IsSasoriDev/HX6-Miner/fab/HX6_revB_BOM_JLCPCB.csv

Comment | Designator | Footprint | Quantity | Manufacturer Part | LCSC Part #
XT60 12V in | J1 | AMASS_XT60-M_1x02_P7.20mm_Vertical | 1 | AMASS XT60PW-M (vertical)
15A mini blade | F1 | Fuseholder_Blade_Mini_Keystone_3568 | 1 | Keystone 3568 holder + 15 A mini blade fuse
SMBJ15CA | D1 | D_SMB | 1 | SMBJ15CA (bidirectional)
270u 16V | C1,C2,C3,C4 | CP_Elec_8x10 | 4 | Panasonic 16SVPF270M (polymer)
100k | R1,R3,R5,R7,R14,R23 | R_0402_1005Metric | 6
10k | R2,R11,R13,R16,R19,R21,R22,R24,R34,R35,R36,R38,R39,R41,R42,R44,R45,R47,R48,R50,R51,R52,R53,R56,R57,R61,R62 | R_0402_1005Metric | 27
100n | C5,C8,C9,C13,C14,C80,C81,C92,C93,C104,C105,C116,C117,C128,C129,C140,C141,C144,C145,C146,C147,C148,C149,C151,C154 | C_0402_1005Metric | 25
TPS54302 | U1,U2 | SOT-23-6 | 2 | TPS54302DDCR
33k | R4 | R_0402_1005Metric | 1
10u 25V | C6,C7,C12 | C_1206_3216Metric | 3
10u | L1 | L_Bourns_SRP7028A_7.3x6.6mm | 1 | Bourns SRP7028A-100M
13.3k | R6 | R_0402_1005Metric | 1
22u 10V | C10,C11,C15,C16,C150 | C_0805_2012Metric | 5
SS34 | D2 | D_SMA | 1 | SS34
6.8u | L2 | L_Bourns_SRP7028A_7.3x6.6mm | 1 | Bourns SRP7028A-6R8M
22.1k | R8 | R_0402_1005Metric | 1
Green | D3 | LED_0603_1608Metric | 1
1k | R9,R33,R37,R40,R43,R46,R49,R58 | R_0402_1005Metric | 8
TLV75801 | U3,U4 | SOT-23-5 | 2 | TLV75801PDBVR
12k | R10 | R_0402_1005Metric | 1
1u | C17,C19,C22,C24,C29,C40,C51,C62,C152 | C_0603_1608Metric | 9
10u | C18,C20,C153 | C_0805_2012Metric | 3
4.53k | R12 | R_0402_1005Metric | 1
TPS53647 | U5 | Texas_RHA0040B_VQFN-40-1EP_6x6mm_P0.5mm_EP4.15x4.15mm_ThermalVias | 1 | TPS53647RTAR
10 | R15 | R_0603_1608Metric | 1
1u 25V | C21 | C_0603_1608Metric | 1
2.2u | C23 | C_0603_1608Metric | 1
14.7k | R17 | R_0402_1005Metric | 1
150k | R18 | R_0402_1005Metric | 1
2.2n | C25 | C_0402_1005Metric | 1
47p | C26 | C_0402_1005Metric | 1
0 | R25,R27,R28 | R_0402_1005Metric | 3
75k | R26 | R_0402_1005Metric | 1
1n | C27 | C_0402_1005Metric | 1
CSD95490Q5MC | U6,U7,U8,U9 | TI_DMC0012A_VSON-CLIP_5x6mm | 4 | CSD95490Q5MC
110k | R29,R30,R31,R32 | R_0402_1005Metric | 4
100n 16V | C28,C39,C50,C61 | C_0402_1005Metric | 4
22u 25V | C30,C31,C41,C42,C52,C53,C63,C64 | C_1210_3225Metric | 8
100n 25V | C32,C43,C54,C65 | C_0402_1005Metric | 4
150n | L3,L4,L5,L6 | L_Coilcraft_XAL7070-XXX | 4 | Coilcraft XAL7070-151MEC
47u 6.3V | C33,C34,C35,C36,C44,C45,C46,C47,C55,C56,C57,C58,C66,C67,C68,C69 | C_1206_3216Metric | 16
470u 2.5V | C37,C38,C48,C49,C59,C60,C70,C71 | CP_EIA-7343-31_Kemet-D | 8 | Panasonic 2R5TPF470M6L (POSCAP)
BM1370 | U10,U11,U12,U13,U14,U15 | BM1370 | 6 | Bitmain BM1370
1u 25V | C72,C73,C74,C75,C76,C77,C78,C79,C84,C85,C86,C87,C88,C89,C90,C91,C96,C97,C98,C99,C100,C101,C102,C103,C108,C109,C110,C111,C112,C113,C114,C115,C120,C121,C122,C123,C124,C125,C126,C127,C132,C133,C134,C135,C136,C137,C138,C139 | C_0402_1005Metric | 48
22u 6.3V | C82,C83,C94,C95,C106,C107,C118,C119,C130,C131,C142,C143 | C_0805_2012Metric | 12
TXU0304 | U16 | TSSOP-14_4.4x5mm_P0.65mm | 1 | TXU0304PWR
25MHz 1.2V | Y1 | Oscillator_SMD_Abracon_ASE-4Pin_3.2x2.5mm | 1 | Taitien OXLTDLJANF-25.000000 (1.2 V CMOS)
TMP1075 | U17,U18,U19 | SO-8_3.9x4.9mm_P1.27mm | 3 | TMP1075DR
ESP32-S3-WROOM-1-N16R8 | U20 | ESP32-S3-WROOM-1 | 1 | ESP32-S3-WROOM-1-N16R8
4.7k | R54,R55 | R_0402_1005Metric | 2
BOOT | SW1 | SW_SPST_TL3342 | 1 | TE FSMSM / TL3342
RESET | SW2 | SW_SPST_TL3342 | 1 | TE FSMSM / TL3342
USER | SW3 | SW_SPST_TL3342 | 1 | TE FSMSM / TL3342
Blue | D4 | LED_0603_1608Metric | 1
UART0 | J2 | PinHeader_1x03_P2.54mm_Vertical | 1
USB-C | J3 | USB_C_Receptacle_HRO_TYPE-C-31-M-12 | 1 | HRO TYPE-C-31-M-12
5.1k | R59,R60 | R_0402_1005Metric | 2
USBLC6-2SC6 | U21 | SOT-23-6 | 1 | USBLC6-2SC6
Waveshare 2.8in CTP | J4 | JST_GH_SM13B-GHS-TB_1x13-1MP_P1.25mm_Horizontal | 1 | JST SM13B-GHS-TB (GH 1.25 mm, 13 pin)
EMC2302-1 | U22 | MSOP-10_3x3mm_P0.5mm | 1 | EMC2302-1-AIZL
FAN1 | J5 | FanPinHeader_1x04_P2.54mm_Vertical | 1 | Molex 47053-1000
FAN2 | J6 | FanPinHeader_1x04_P2.54mm_Vertical | 1 | Molex 47053-1000
