IsSasoriDev/HX6-Miner/hx6.kicad_pcb

## KiCad design hx6.kicad_pcb (2026-10-30)

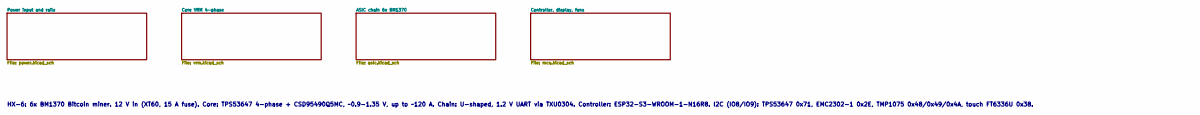
[picture p5: schematic hx6.kicad_sch, HX-6 6x BM1370 miner]

Notes on the sheet:
HX-6: 6x BM1370 Bitcoin miner. 12 V in (XT60, 15 A fuse). Core: TPS53647 4-phase + CSD95490Q5MC, ~0.9-1.35 V, up to ~120 A. Chain: U-shaped, 1.2 V UART via TXU0304. Controller: ESP32-S3-WROOM-1-N16R8. I2C (IO8/IO9): TPS53647 0x71, EMC2302-1 0x2E, TMP1075 0x48/0x49/0x4A, touch FT6336U 0x38.

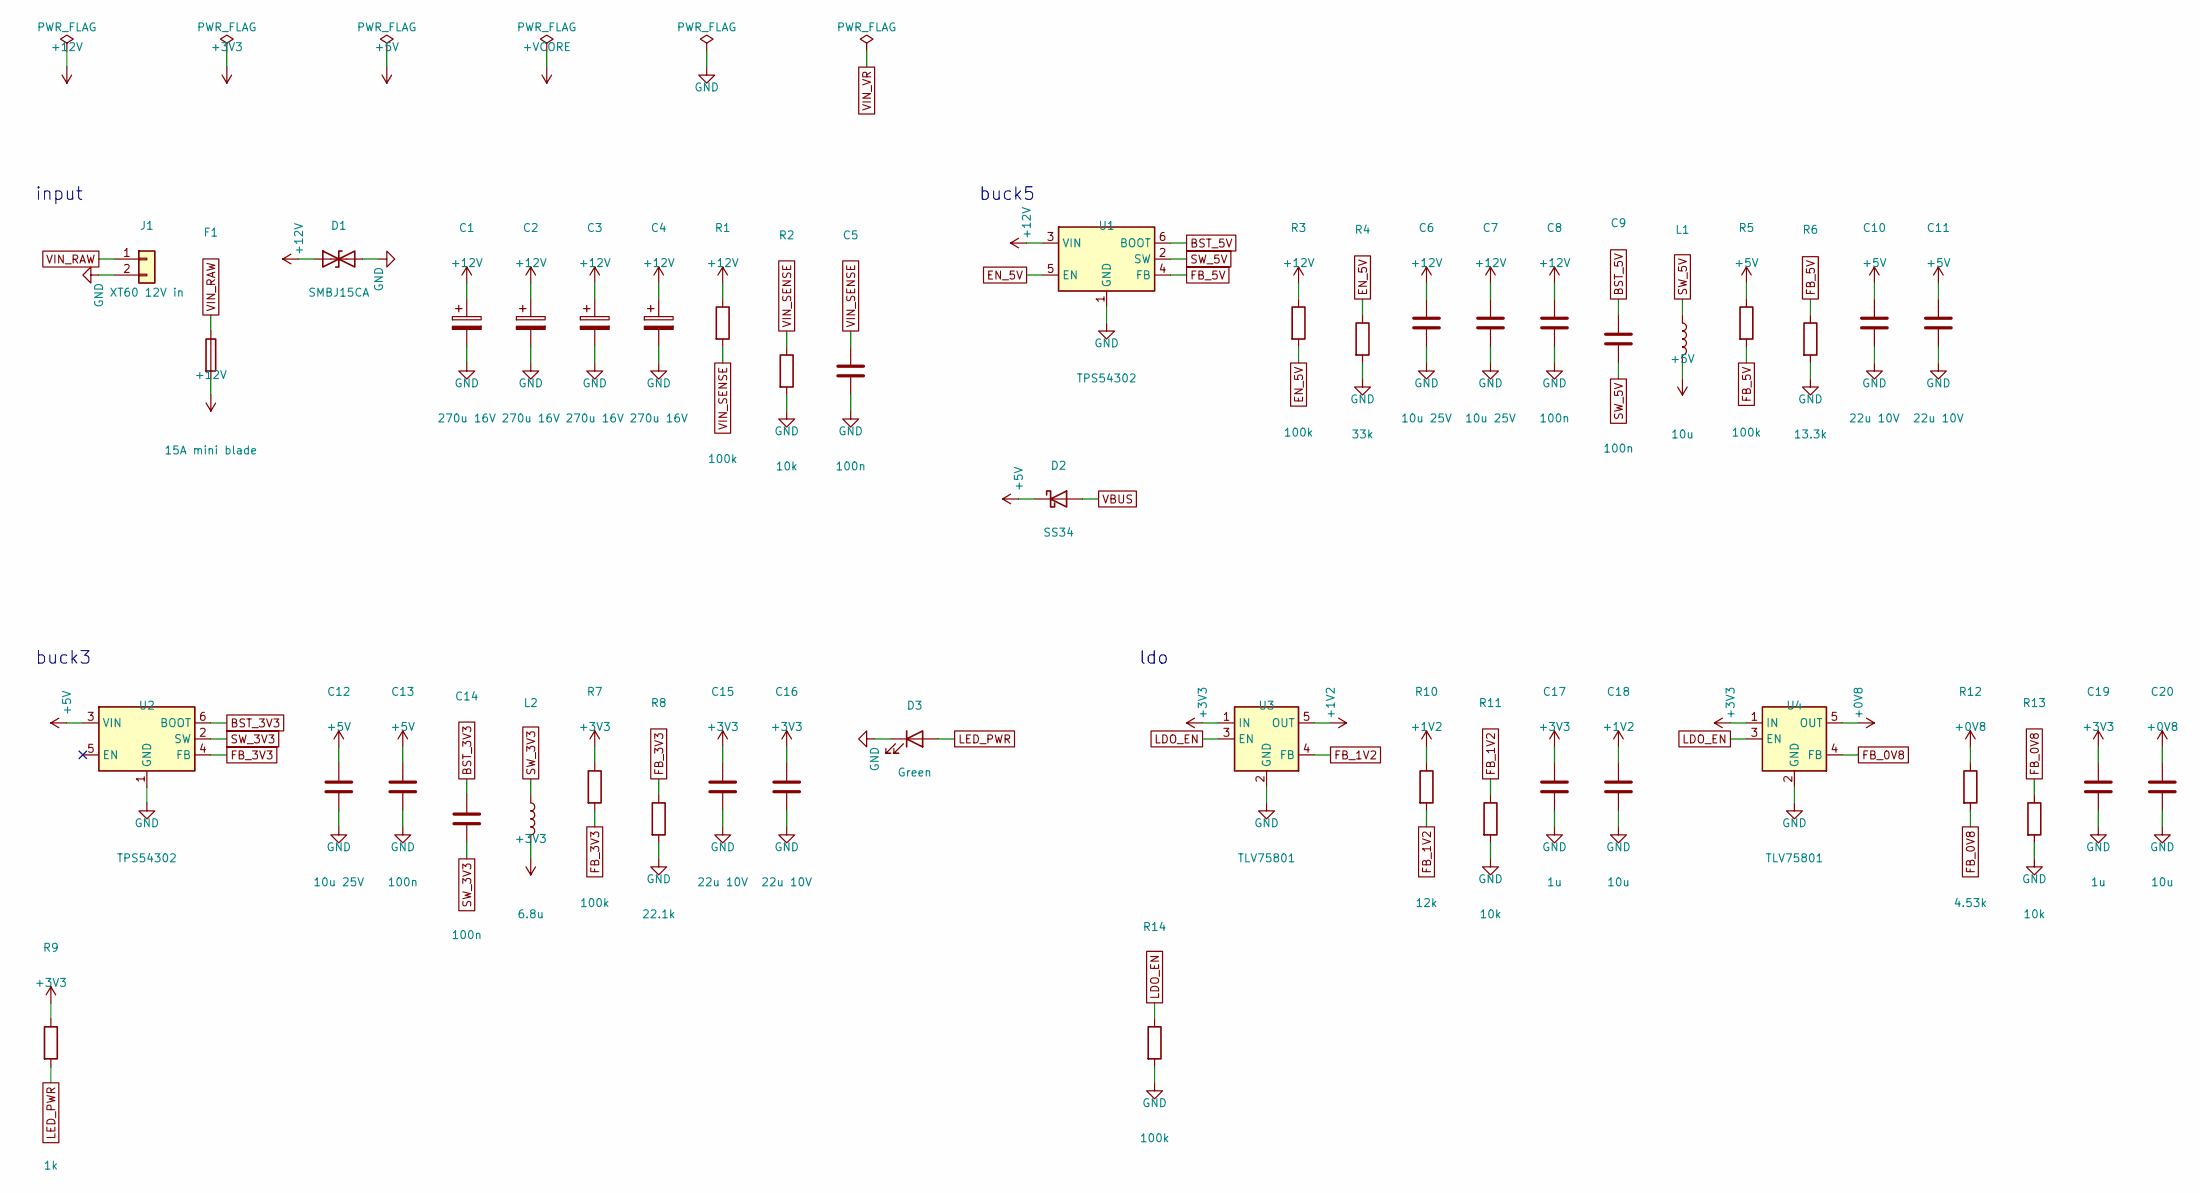
[picture p6: schematic power.kicad_sch, HX-6 Power input and rails]

Parts:
C1, C2, C3, C4: 270u 16V; CP_Elec_8x10; MPN Panasonic 16SVPF270M (polymer)
C5, C8, C9, C13, C14: 100n; C_0402_1005Metric
C6, C7, C12: 10u 25V; C_1206_3216Metric
C10, C11, C15, C16: 22u 10V; C_0805_2012Metric
C17, C19: 1u; C_0603_1608Metric
C18, C20: 10u; C_0805_2012Metric
D1: SMBJ15CA; D_SMB; MPN SMBJ15CA (bidirectional)
D2: SS34; D_SMA; MPN SS34
D3: Green; LED_0603_1608Metric
F1: 15A mini blade; Fuseholder_Blade_Mini_Keystone_3568; MPN Keystone 3568 holder + 15 A mini blade 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
J1: XT60 12V in; AMASS_XT60-M_1x02_P7.20mm_Vertical; MPN AMASS XT60PW-M (vertical)
L1: 10u; L_Bourns_SRP7028A_7.3x6.6mm; MPN Bourns SRP7028A-100M
L2: 6.8u; L_Bourns_SRP7028A_7.3x6.6mm; MPN Bourns SRP7028A-6R8M
R1, R3, R5, R7, R14: 100k; R_0402_1005Metric
R2, R11, R13: 10k; R_0402_1005Metric
R4: 33k; R_0402_1005Metric
R6: 13.3k; R_0402_1005Metric
R8: 22.1k; R_0402_1005Metric
R9: 1k; R_0402_1005Metric
R10: 12k; R_0402_1005Metric
R12: 4.53k; R_0402_1005Metric
U1, U2: TPS54302; SOT-23-6; MPN TPS54302DDCR
U3, U4: TLV75801; SOT-23-5; MPN TLV75801PDBVR

Connections:
+0V8: C20.1, R12.1, U4.5 (OUT); also elsewhere on the board
+1V2: C18.1, R10.1, U3.5 (OUT); also elsewhere on the board
+3V3: C15.1, C16.1, C17.1, C19.1, L2.2, R7.1, R9.1, U3.1 (IN), U4.1 (IN); also elsewhere on the board
+5V: C10.1, C11.1, C12.1, C13.1, D2.1 (K), L1.2, R5.1, U2.3 (VIN); also elsewhere on the board
+12V: C1.1, C2.1, C3.1, C4.1, C6.1, C7.1, C8.1, D1.1 (A1), F1.2, R1.1, R3.1, U1.3 (VIN); also elsewhere on the board
BST_3V3: C14.1, U2.6 (BOOT)
BST_5V: C9.1, U1.6 (BOOT)
EN_5V: R3.2, R4.1, U1.5 (EN)
FB_0V8: R12.2, R13.1, U4.4 (FB)
FB_1V2: R10.2, R11.1, U3.4 (FB)
FB_3V3: R7.2, R8.1, U2.4 (FB)
FB_5V: R5.2, R6.1, U1.4 (FB)
GND: C1.2, C2.2, C3.2, C4.2, C5.2, C6.2, C7.2, C8.2, C10.2, C11.2, C12.2, C13.2, C15.2, C16.2, C17.2, C18.2, C19.2, C20.2, D1.2 (A2), D3.1 (K), J1.2, R2.2, R4.2, R6.2, R8.2, R11.2, R13.2, R14.2, U1.1 (GND), U2.1 (GND), U3.2 (GND), U4.2 (GND); also elsewhere on the board
LDO_EN: R14.1, U3.3 (EN), U4.3 (EN); also elsewhere on the board
LED_PWR: D3.2 (A), R9.2
SW_3V3: C14.2, L2.1, U2.2 (SW)
SW_5V: C9.2, L1.1, U1.2 (SW)
VBUS: D2.2 (A); also elsewhere on the board
VIN_RAW: F1.1, J1.1
VIN_SENSE: C5.1, R1.2, R2.1; also elsewhere on the board

Notes on the sheet:
input
buck5
buck3
ldo

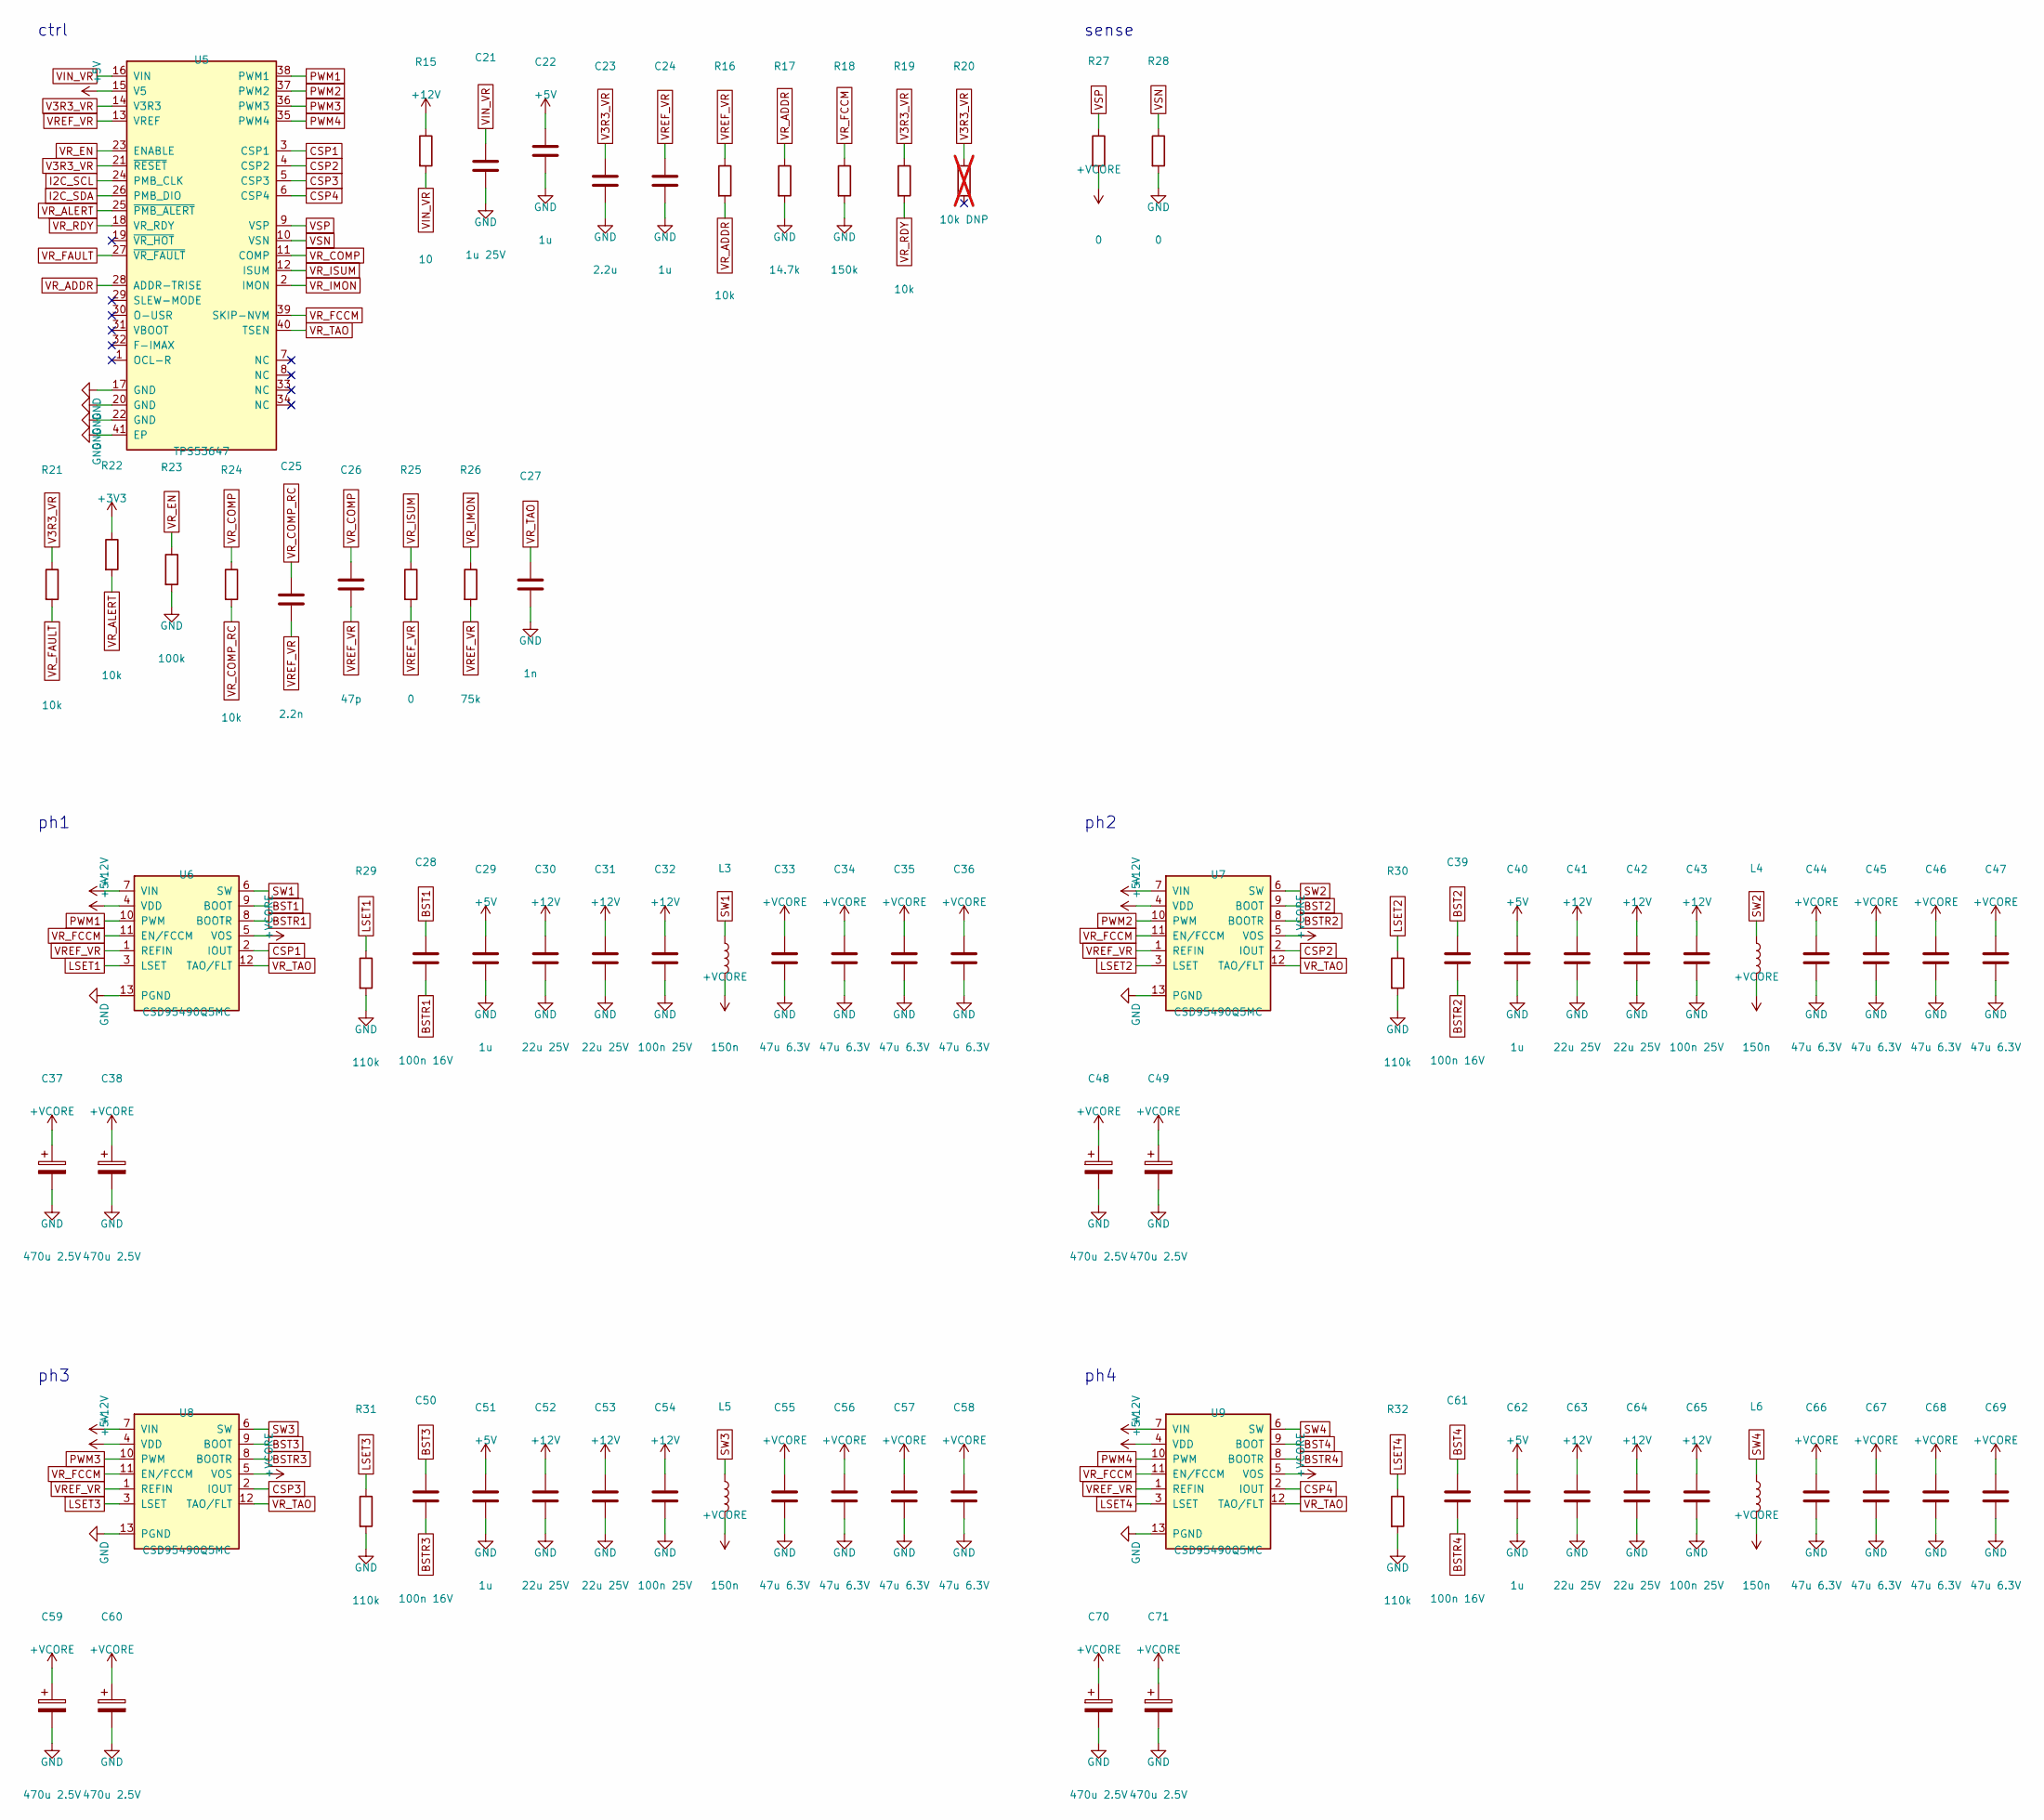
[picture p7: schematic vrm.kicad_sch, HX-6 Core VRM 4-phase]

Parts:
C21: 1u 25V; C_0603_1608Metric
C22, C24, C29, C40, C51, C62: 1u; C_0603_1608Metric
C23: 2.2u; C_0603_1608Metric
C25: 2.2n; C_0402_1005Metric
C26: 47p; C_0402_1005Metric
C27: 1n; C_0402_1005Metric
C28, C39, C50, C61: 100n 16V; C_0402_1005Metric
C30, C31, C41, C42, C52, C53, C63, C64: 22u 25V; C_1210_3225Metric
C32, C43, C54, C65: 100n 25V; C_0402_1005Metric
C33, C34, C35, C36, C44, C45, C46, C47, C55, C56, C57, C58, C66, C67, C68, C69: 47u 6.3V; C_1206_3216Metric
C37, C38, C48, C49, C59, C60, C70, C71: 470u 2.5V; CP_EIA-7343-31_Kemet-D; MPN Panasonic 2R5TPF470M6L (POSCAP)
L3, L4, L5, L6: 150n; L_Coilcraft_XAL7070-XXX; MPN Coilcraft XAL7070-151MEC
R15: 10; R_0603_1608Metric
R16, R19, R21, R22, R24: 10k; R_0402_1005Metric
R17: 14.7k; R_0402_1005Metric
R18: 150k; R_0402_1005Metric
R20: 10k DNP; R_0402_1005Metric; not fitted
R23: 100k; R_0402_1005Metric
R25, R27, R28: 0; R_0402_1005Metric
R26: 75k; R_0402_1005Metric
R29, R30, R31, R32: 110k; R_0402_1005Metric
U5: TPS53647; Texas_RHA0040B_VQFN-40-1EP_6x6mm_P0.5mm_EP4.15x4.15mm_Therm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; MPN TPS53647RTAR
U6, U7, U8, U9: CSD95490Q5MC; TI_DMC0012A_VSON-CLIP_5x6mm; MPN CSD95490Q5MC

Connections:
+3V3: R22.1; also elsewhere on the board
+5V: C22.1, C29.1, C40.1, C51.1, C62.1, U5.15 (V5), U6.4 (VDD), U7.4 (VDD), U8.4 (VDD), U9.4 (VDD); also elsewhere on the board
+12V: C30.1, C31.1, C32.1, C41.1, C42.1, C43.1, C52.1, C53.1, C54.1, C63.1, C64.1, C65.1, R15.1, U6.7 (VIN), U7.7 (VIN), U8.7 (VIN), U9.7 (VIN); also elsewhere on the board
+VCORE: C33.1, C34.1, C35.1, C36.1, C37.1, C38.1, C44.1, C45.1, C46.1, C47.1, C48.1, C49.1, C55.1, C56.1, C57.1, C58.1, C59.1, C60.1, C66.1, C67.1, C68.1, C69.1, C70.1, C71.1, L3.2, L4.2, L5.2, L6.2, R27.2, U6.5 (VOS), U7.5 (VOS), U8.5 (VOS), U9.5 (VOS); also elsewhere on the board
BST1: C28.1, U6.9 (BOOT)
BST2: C39.1, U7.9 (BOOT)
BST3: C50.1, U8.9 (BOOT)
BST4: C61.1, U9.9 (BOOT)
BSTR1: C28.2, U6.8 (BOOTR)
BSTR2: C39.2, U7.8 (BOOTR)
BSTR3: C50.2, U8.8 (BOOTR)
BSTR4: C61.2, U9.8 (BOOTR)
CSP1: U5.3 (CSP1), U6.2 (IOUT)
CSP2: U5.4 (CSP2), U7.2 (IOUT)
CSP3: U5.5 (CSP3), U8.2 (IOUT)
CSP4: U5.6 (CSP4), U9.2 (IOUT)
GND: C21.2, C22.2, C23.2, C24.2, C27.2, C29.2, C30.2, C31.2, C32.2, C33.2, C34.2, C35.2, C36.2, C37.2, C38.2, C40.2, C41.2, C42.2, C43.2, C44.2, C45.2, C46.2, C47.2, C48.2, C49.2, C51.2, C52.2, C53.2, C54.2, C55.2, C56.2, C57.2, C58.2, C59.2, C60.2, C62.2, C63.2, C64.2, C65.2, C66.2, C67.2, C68.2, C69.2, C70.2, C71.2, R17.2, R18.2, R23.2, R28.2, R29.2, R30.2, R31.2, R32.2, U5.17 (GND), U5.20 (GND), U5.22 (GND), U5.41 (EP), U6.13 (PGND), U7.13 (PGND), U8.13 (PGND), U9.13 (PGND); also elsewhere on the board
I2C_SCL: U5.24 (PMB_CLK); also elsewhere on the board
I2C_SDA: U5.26 (PMB_DIO); also elsewhere on the board
LSET1: R29.1, U6.3 (LSET)
LSET2: R30.1, U7.3 (LSET)
LSET3: R31.1, U8.3 (LSET)
LSET4: R32.1, U9.3 (LSET)
PWM1: U5.38 (PWM1), U6.10 (PWM)
PWM2: U5.37 (PWM2), U7.10 (PWM)
PWM3: U5.36 (PWM3), U8.10 (PWM)
PWM4: U5.35 (PWM4), U9.10 (PWM)
SW1: L3.1, U6.6 (SW)
SW2: L4.1, U7.6 (SW)
SW3: L5.1, U8.6 (SW)
SW4: L6.1, U9.6 (SW)
V3R3_VR: C23.1, R19.1, R20.1, R21.1, U5.14 (V3R3), U5.21 (~RESET)
VIN_VR: C21.1, R15.2, U5.16 (VIN)
VREF_VR: C24.1, C25.2, C26.2, R16.1, R25.2, R26.2, U5.13 (VREF), U6.1 (REFIN), U7.1 (REFIN), U8.1 (REFIN), U9.1 (REFIN)
VR_ADDR: R16.2, R17.1, U5.28 (ADDR-TRISE)
VR_ALERT: R22.2, U5.25 (~PMB_ALERT); also elsewhere on the board
VR_COMP: C26.1, R24.1, U5.11 (COMP)
VR_COMP_RC: C25.1, R24.2
VR_EN: R23.1, U5.23 (ENABLE); also elsewhere on the board
VR_FAULT: R21.2, U5.27 (~VR_FAULT)
VR_FCCM: R18.1, U5.39 (SKIP-NVM), U6.11 (EN/FCCM), U7.11 (EN/FCCM), U8.11 (EN/FCCM), U9.11 (EN/FCCM)
VR_IMON: R26.1, U5.2 (IMON)
VR_ISUM: R25.1, U5.12 (ISUM)
VR_RDY: R19.2, U5.18 (VR_RDY); also elsewhere on the board
VR_TAO: C27.1, U5.40 (TSEN), U6.12 (TAO/FLT), U7.12 (TAO/FLT), U8.12 (TAO/FLT), U9.12 (TAO/FLT)
VSN: R28.1, U5.10 (VSN)
VSP: R27.1, U5.9 (VSP)

Notes on the sheet:
ctrl
sense
ph1
ph2
ph3
ph4

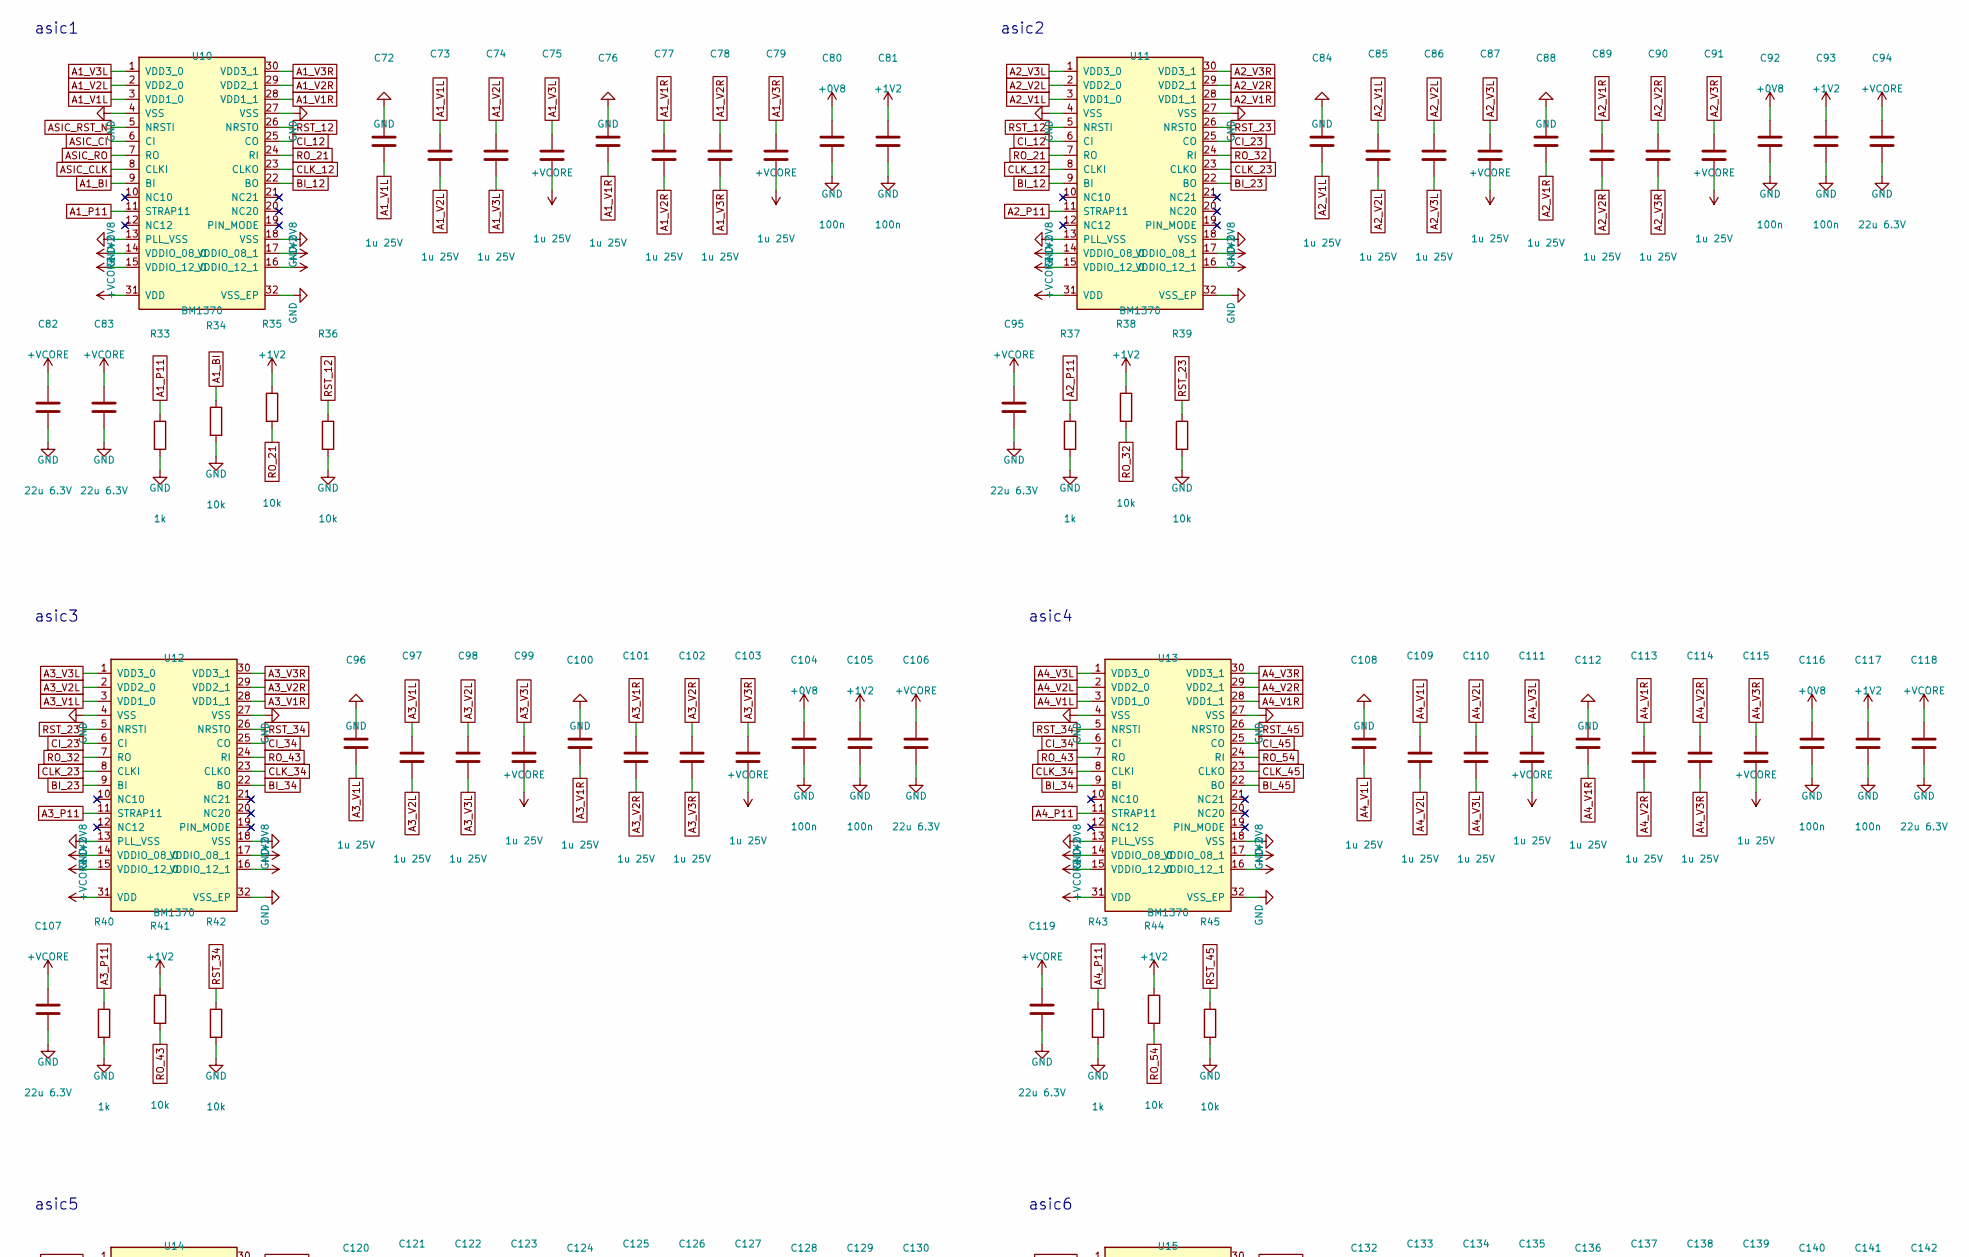
[picture p8: schematic asic.kicad_sch, HX-6 ASIC chain 6x BM1370, part in row 1, column 1]

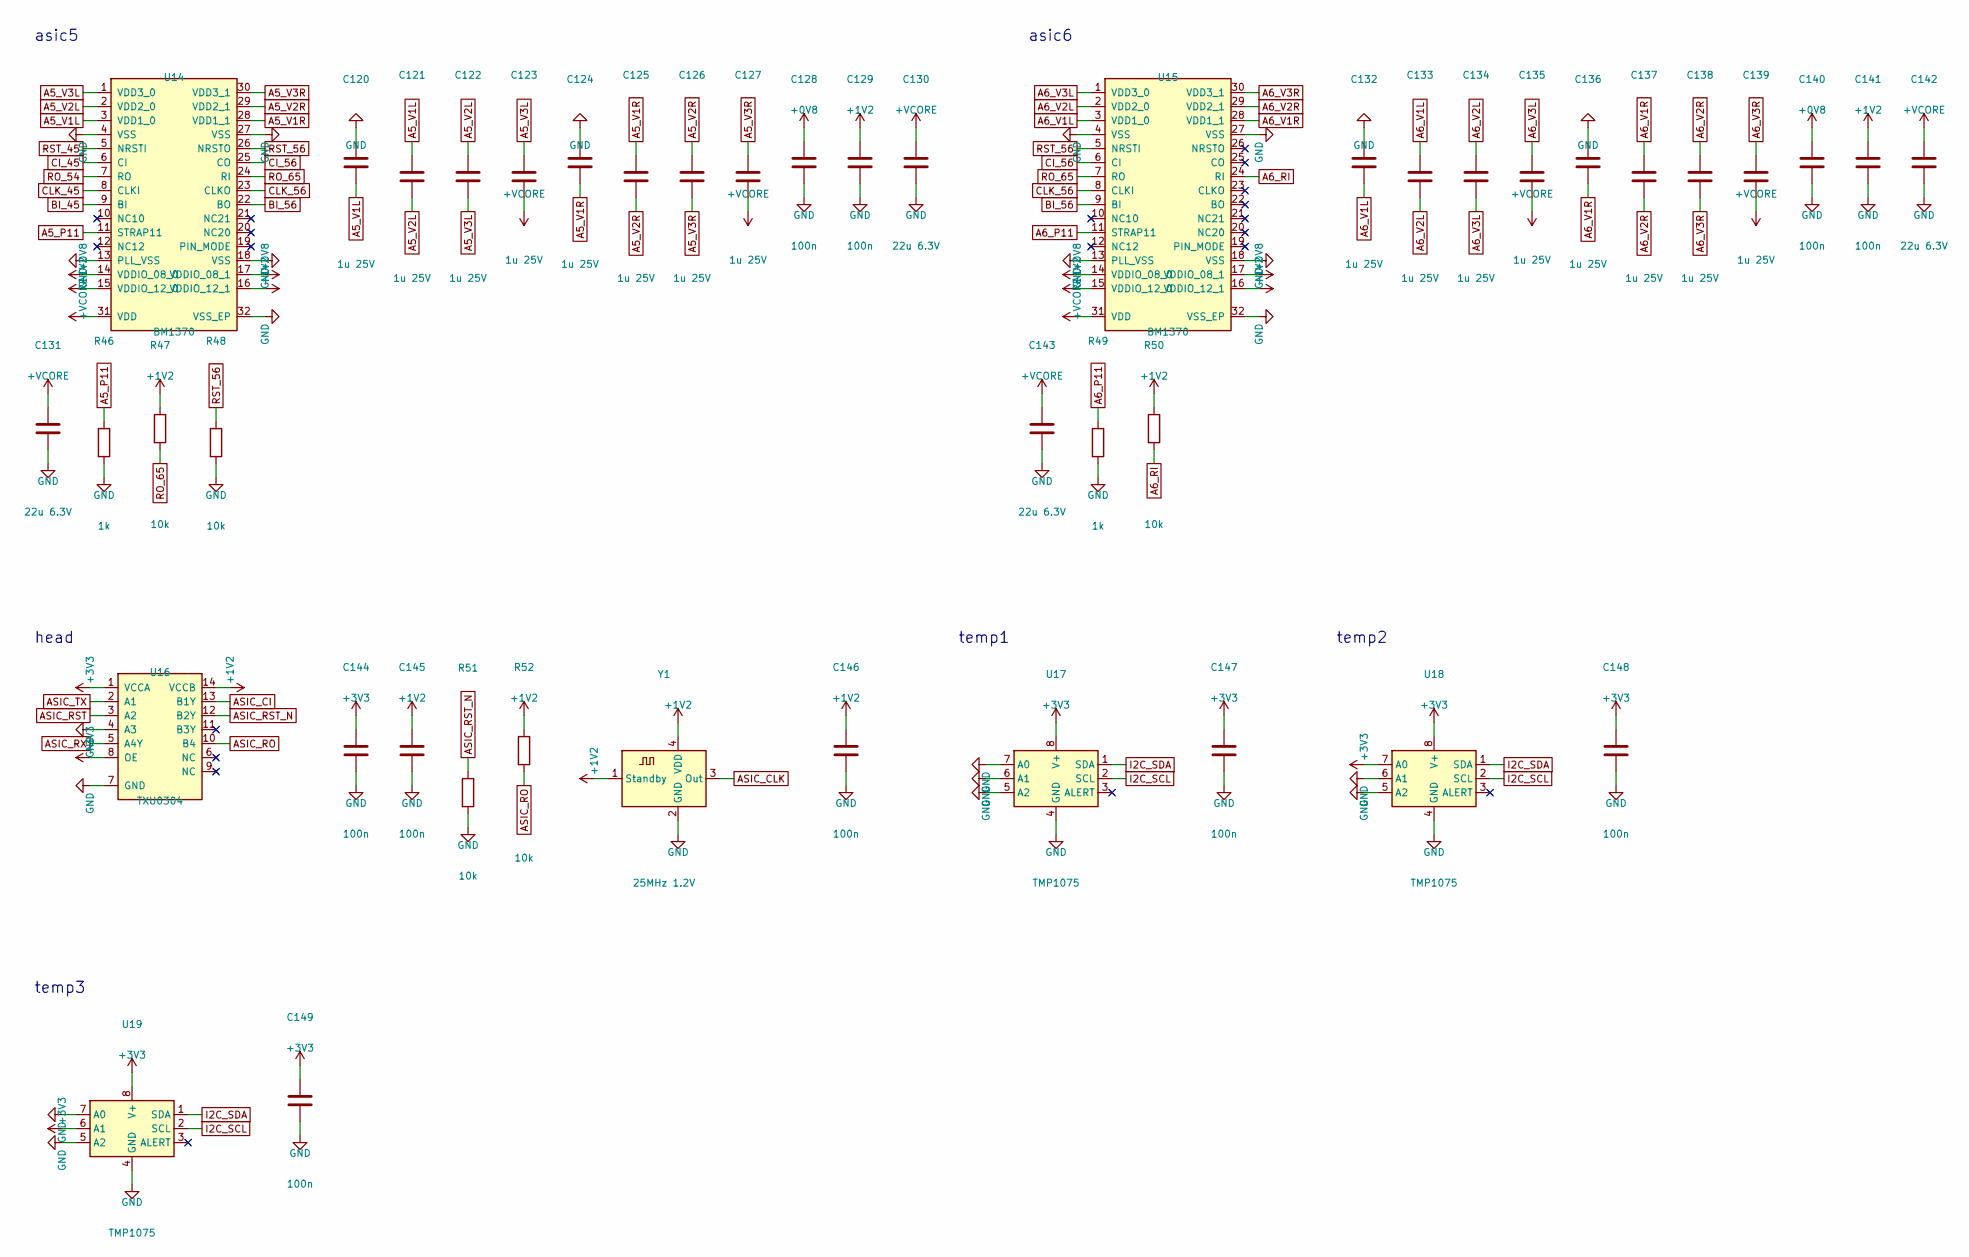
[picture p9: schematic asic.kicad_sch, HX-6 ASIC chain 6x BM1370, part in row 2, column 1]

Parts:
C72, C73, C74, C75, C76, C77, C78, C79, C84, C85, C86, C87, C88, C89, C90, C91, C96, C97, C98, C99, C100, C101, C102, C103, C108, C109, C110, C111, C112, C113, C114, C115, C120, C121, C122, C123, C124, C125, C126, C127, C132, C133, C134, C135, C136, C137, C138, C139: 1u 25V; C_0402_1005Metric
C80, C81, C92, C93, C104, C105, C116, C117, C128, C129, C140, C141, C144, C145, C146, C147, C148, C149: 100n; C_0402_1005Metric
C82, C83, C94, C95, C106, C107, C118, C119, C130, C131, C142, C143: 22u 6.3V; C_0805_2012Metric
R33, R37, R40, R43, R46, R49: 1k; R_0402_1005Metric
R34, R35, R36, R38, R39, R41, R42, R44, R45, R47, R48, R50, R51, R52: 10k; R_0402_1005Metric
U10, U11, U12, U13, U14, U15: BM1370; MPN Bitmain BM1370
U16: TXU0304; TSSOP-14_4.4x5mm_P0.65mm; MPN TXU0304PWR
U17, U18, U19: TMP1075; SO-8_3.9x4.9mm_P1.27mm; MPN TMP1075DR
Y1: 25MHz 1.2V; Oscillator_SMD_Abracon_ASE-4Pin_3.2x2.5mm; MPN Taitien OXLTDLJANF-25.000000 (1.2 V CMO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

Connections:
+0V8: C80.1, C92.1, C104.1, C116.1, C128.1, C140.1, U10.14 (VDDIO_08_0), U10.17 (VDDIO_08_1), U11.14 (VDDIO_08_0), U11.17 (VDDIO_08_1), U12.14 (VDDIO_08_0), U12.17 (VDDIO_08_1), U13.14 (VDDIO_08_0), U13.17 (VDDIO_08_1), U14.14 (VDDIO_08_0), U14.17 (VDDIO_08_1), U15.14 (VDDIO_08_0), U15.17 (VDDIO_08_1); also elsewhere on the board
+1V2: C81.1, C93.1, C105.1, C117.1, C129.1, C141.1, C145.1, C146.1, R35.1, R38.1, R41.1, R44.1, R47.1, R50.1, R52.1, U10.15 (VDDIO_12_0), U10.16 (VDDIO_12_1), U11.15 (VDDIO_12_0), U11.16 (VDDIO_12_1), U12.15 (VDDIO_12_0), U12.16 (VDDIO_12_1), U13.15 (VDDIO_12_0), U13.16 (VDDIO_12_1), U14.15 (VDDIO_12_0), U14.16 (VDDIO_12_1), U15.15 (VDDIO_12_0), U15.16 (VDDIO_12_1), U16.14 (VCCB), Y1.1 (Standby), Y1.4 (VDD); also elsewhere on the board
+3V3: C144.1, C147.1, C148.1, C149.1, U16.1 (VCCA), U16.8 (OE), U17.8 (V+), U18.7 (A0), U18.8 (V+), U19.6 (A1), U19.8 (V+); also elsewhere on the board
+VCORE: C75.2, C79.2, C82.1, C83.1, C87.2, C91.2, C94.1, C95.1, C99.2, C103.2, C106.1, C107.1, C111.2, C115.2, C118.1, C119.1, C123.2, C127.2, C130.1, C131.1, C135.2, C139.2, C142.1, C143.1, U10.31 (VDD), U11.31 (VDD), U12.31 (VDD), U13.31 (VDD), U14.31 (VDD), U15.31 (VDD); also elsewhere on the board
A1_BI: R34.1, U10.9 (BI)
A1_P11: R33.1, U10.11 (STRAP11)
A1_V1L: C72.2, C73.1, U10.3 (VDD1_0)
A1_V1R: C76.2, C77.1, U10.28 (VDD1_1)
A1_V2L: C73.2, C74.1, U10.2 (VDD2_0)
A1_V2R: C77.2, C78.1, U10.29 (VDD2_1)
A1_V3L: C74.2, C75.1, U10.1 (VDD3_0)
A1_V3R: C78.2, C79.1, U10.30 (VDD3_1)
A2_P11: R37.1, U11.11 (STRAP11)
A2_V1L: C84.2, C85.1, U11.3 (VDD1_0)
A2_V1R: C88.2, C89.1, U11.28 (VDD1_1)
A2_V2L: C85.2, C86.1, U11.2 (VDD2_0)
A2_V2R: C89.2, C90.1, U11.29 (VDD2_1)
A2_V3L: C86.2, C87.1, U11.1 (VDD3_0)
A2_V3R: C90.2, C91.1, U11.30 (VDD3_1)
A3_P11: R40.1, U12.11 (STRAP11)
A3_V1L: C96.2, C97.1, U12.3 (VDD1_0)
A3_V1R: C100.2, C101.1, U12.28 (VDD1_1)
A3_V2L: C97.2, C98.1, U12.2 (VDD2_0)
A3_V2R: C101.2, C102.1, U12.29 (VDD2_1)
A3_V3L: C98.2, C99.1, U12.1 (VDD3_0)
A3_V3R: C102.2, C103.1, U12.30 (VDD3_1)
A4_P11: R43.1, U13.11 (STRAP11)
A4_V1L: C108.2, C109.1, U13.3 (VDD1_0)
A4_V1R: C112.2, C113.1, U13.28 (VDD1_1)
A4_V2L: C109.2, C110.1, U13.2 (VDD2_0)
A4_V2R: C113.2, C114.1, U13.29 (VDD2_1)
A4_V3L: C110.2, C111.1, U13.1 (VDD3_0)
A4_V3R: C114.2, C115.1, U13.30 (VDD3_1)
A5_P11: R46.1, U14.11 (STRAP11)
A5_V1L: C120.2, C121.1, U14.3 (VDD1_0)
A5_V1R: C124.2, C125.1, U14.28 (VDD1_1)
A5_V2L: C121.2, C122.1, U14.2 (VDD2_0)
A5_V2R: C125.2, C126.1, U14.29 (VDD2_1)
A5_V3L: C122.2, C123.1, U14.1 (VDD3_0)
A5_V3R: C126.2, C127.1, U14.30 (VDD3_1)
A6_P11: R49.1, U15.11 (STRAP11)
A6_RI: R50.2, U15.24 (RI)
A6_V1L: C132.2, C133.1, U15.3 (VDD1_0)
A6_V1R: C136.2, C137.1, U15.28 (VDD1_1)
A6_V2L: C133.2, C134.1, U15.2 (VDD2_0)
A6_V2R: C137.2, C138.1, U15.29 (VDD2_1)
A6_V3L: C134.2, C135.1, U15.1 (VDD3_0)
A6_V3R: C138.2, C139.1, U15.30 (VDD3_1)
ASIC_CI: U10.6 (CI), U16.13 (B1Y)
ASIC_CLK: U10.8 (CLKI), Y1.3 (Out)
ASIC_RO: R52.2, U10.7 (RO), U16.10 (B4)
ASIC_RST: U16.3 (A2); also elsewhere on the board
ASIC_RST_N: R51.1, U10.5 (NRSTI), U16.12 (B2Y)
ASIC_RX: U16.5 (A4Y); also elsewhere on the board
ASIC_TX: U16.2 (A1); also elsewhere on the board
BI_12: U10.22 (BO), U11.9 (BI)
BI_23: U11.22 (BO), U12.9 (BI)
BI_34: U12.22 (BO), U13.9 (BI)
BI_45: U13.22 (BO), U14.9 (BI)
BI_56: U14.22 (BO), U15.9 (BI)
CI_12: U10.25 (CO), U11.6 (CI)
CI_23: U11.25 (CO), U12.6 (CI)
CI_34: U12.25 (CO), U13.6 (CI)
CI_45: U13.25 (CO), U14.6 (CI)
CI_56: U14.25 (CO), U15.6 (CI)
CLK_12: U10.23 (CLKO), U11.8 (CLKI)
CLK_23: U11.23 (CLKO), U12.8 (CLKI)
CLK_34: U12.23 (CLKO), U13.8 (CLKI)
CLK_45: U13.23 (CLKO), U14.8 (CLKI)
CLK_56: U14.23 (CLKO), U15.8 (CLKI)
GND: C72.1, C76.1, C80.2, C81.2, C82.2, C83.2, C84.1, C88.1, C92.2, C93.2, C94.2, C95.2, C96.1, C100.1, C104.2, C105.2, C106.2, C107.2, C108.1, C112.1, C116.2, C117.2, C118.2, C119.2, C120.1, C124.1, C128.2, C129.2, C130.2, C131.2, C132.1, C136.1, C140.2, C141.2, C142.2, C143.2, C144.2, C145.2, C146.2, C147.2, C148.2, C149.2, R33.2, R34.2, R36.2, R37.2, R39.2, R40.2, R42.2, R43.2, R45.2, R46.2, R48.2, R49.2, R51.2, U10.4 (VSS), U10.13 (PLL_VSS), U10.18 (VSS), U10.27 (VSS), U10.32 (VSS_EP), U11.4 (VSS), U11.13 (PLL_VSS), U11.18 (VSS), U11.27 (VSS), U11.32 (VSS_EP), U12.4 (VSS), U12.13 (PLL_VSS), U12.18 (VSS), U12.27 (VSS), U12.32 (VSS_EP), U13.4 (VSS), U13.13 (PLL_VSS), U13.18 (VSS), U13.27 (VSS), U13.32 (VSS_EP), U14.4 (VSS), U14.13 (PLL_VSS), U14.18 (VSS), U14.27 (VSS), U14.32 (VSS_EP), U15.4 (VSS), U15.13 (PLL_VSS), U15.18 (VSS), U15.27 (VSS), U15.32 (VSS_EP), U16.4 (A3), U16.7 (GND), U17.4 (GND), U17.5 (A2), U17.6 (A1), U17.7 (A0), U18.4 (GND), U18.5 (A2), U18.6 (A1), U19.4 (GND), U19.5 (A2), U19.7 (A0), Y1.2 (GND); also elsewhere on the board
I2C_SCL: U17.2 (SCL), U18.2 (SCL), U19.2 (SCL); also elsewhere on the board
I2C_SDA: U17.1 (SDA), U18.1 (SDA), U19.1 (SDA); also elsewhere on the board
RO_21: R35.2, U10.24 (RI), U11.7 (RO)
RO_32: R38.2, U11.24 (RI), U12.7 (RO)
RO_43: R41.2, U12.24 (RI), U13.7 (RO)
RO_54: R44.2, U13.24 (RI), U14.7 (RO)
RO_65: R47.2, U14.24 (RI), U15.7 (RO)
RST_12: R36.1, U10.26 (NRSTO), U11.5 (NRSTI)
RST_23: R39.1, U11.26 (NRSTO), U12.5 (NRSTI)
RST_34: R42.1, U12.26 (NRSTO), U13.5 (NRSTI)
RST_45: R45.1, U13.26 (NRSTO), U14.5 (NRSTI)
RST_56: R48.1, U14.26 (NRSTO), U15.5 (NRSTI)

Notes on the sheet:
asic1
asic2
asic3
asic4
asic5
asic6
head
temp1
temp2
temp3
