IsSasoriDev/HX6-Miner/hx6.kicad_pcb

## KiCad design hx6.kicad_pcb (continued)

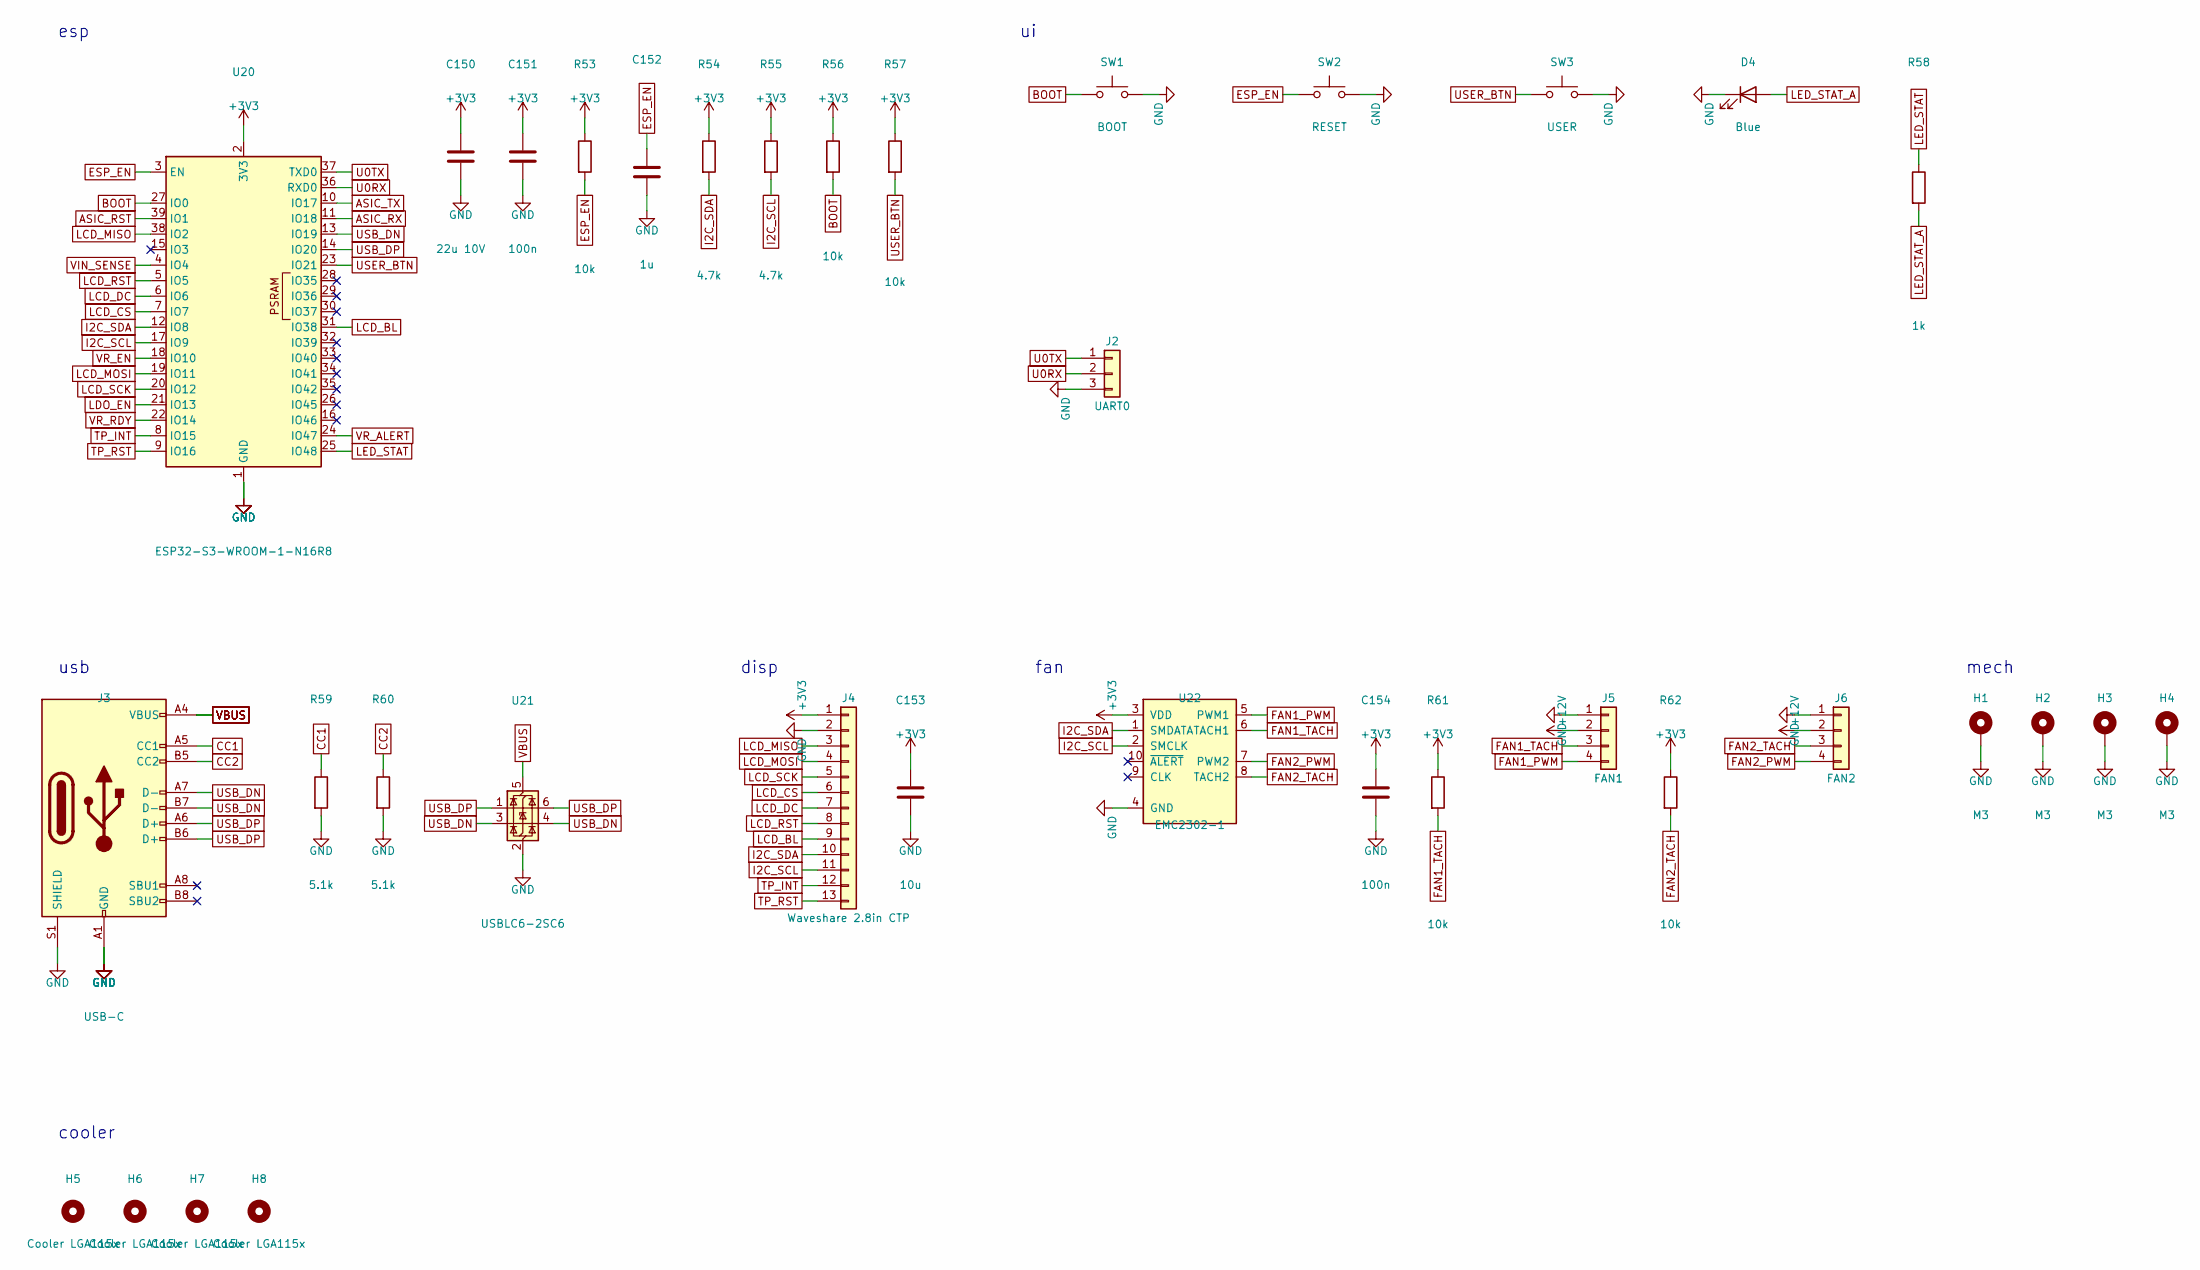
[picture p10: schematic mcu.kicad_sch, HX-6 Controller, display, fans]

Parts:
C150: 22u 10V; C_0805_2012Metric
C151, C154: 100n; C_0402_1005Metric
C152: 1u; C_0603_1608Metric
C153: 10u; C_0805_2012Metric
D4: Blue; LED_0603_1608Metric
H1, H2, H3, H4: M3; MountingHole_3.2mm_M3_Pad_Via
H5, H6, H7, H8: Cooler LGA115x; CoolerHole_4.0mm_NPTH
J2: UART0; PinHeader_1x03_P2.54mm_Vertical
J3: USB-C; USB_C_Receptacle_HRO_TYPE-C-31-M-12; MPN HRO TYPE-C-31-M-12
J4: Waveshare 2.8in CTP; JST_GH_SM13B-GHS-TB_1x13-1MP_P1.25mm_Horizontal; MPN JST SM13B-GHS-TB (GH 1.25 mm, 13 pin)
J5: FAN1; FanPinHeader_1x04_P2.54mm_Vertical; MPN Molex 47053-1000
J6: FAN2; FanPinHeader_1x04_P2.54mm_Vertical; MPN Molex 47053-1000
R53, R56, R57, R61, R62: 10k; R_0402_1005Metric
R54, R55: 4.7k; R_0402_1005Metric
R58: 1k; R_0402_1005Metric
R59, R60: 5.1k; R_0402_1005Metric
SW1: BOOT; SW_SPST_TL3342; MPN TE FSMSM / TL3342
SW2: RESET; SW_SPST_TL3342; MPN TE FSMSM / TL3342
SW3: USER; SW_SPST_TL3342; MPN TE FSMSM / TL3342
U20: ESP32-S3-WROOM-1-N16R8; ESP32-S3-WROOM-1; MPN ESP32-S3-WROOM-1-N16R8
U21: USBLC6-2SC6; SOT-23-6; MPN USBLC6-2SC6
U22: EMC2302-1; MSOP-10_3x3mm_P0.5mm; MPN EMC2302-1-AIZL

Connections:
+3V3: C150.1, C151.1, C153.1, C154.1, J4.1, R53.1, R54.1, R55.1, R56.1, R57.1, R61.1, R62.1, U20.2 (3V3), U22.3 (VDD); also elsewhere on the board
+12V: J5.2, J6.2; also elsewhere on the board
ASIC_RST: U20.39 (IO1); also elsewhere on the board
ASIC_RX: U20.11 (IO18); also elsewhere on the board
ASIC_TX: U20.10 (IO17); also elsewhere on the board
BOOT: R56.2, SW1.1, U20.27 (IO0)
CC1: J3.A5 (CC1), R59.1
CC2: J3.B5 (CC2), R60.1
ESP_EN: C152.1, R53.2, SW2.1, U20.3 (EN)
FAN1_PWM: J5.4, U22.5 (PWM1)
FAN1_TACH: J5.3, R61.2, U22.6 (TACH1)
FAN2_PWM: J6.4, U22.7 (PWM2)
FAN2_TACH: J6.3, R62.2, U22.8 (TACH2)
GND: C150.2, C151.2, C152.2, C153.2, C154.2, D4.1 (K), H1.1, H2.1, H3.1, H4.1, J2.3, J3.A1 (GND), J3.A12 (GND), J3.B1 (GND), J3.B12 (GND), J3.S1 (SHIELD), J4.2, J5.1, J6.1, R59.2, R60.2, SW1.2, SW2.2, SW3.2, U20.1 (GND), U20.40 (GND), U20.41 (GND), U21.2 (GND), U22.4 (GND); also elsewhere on the board
I2C_SCL: J4.11, R55.2, U20.17 (IO9), U22.2 (SMCLK); also elsewhere on the board
I2C_SDA: J4.10, R54.2, U20.12 (IO8), U22.1 (SMDATA); also elsewhere on the board
LCD_BL: J4.9, U20.31 (IO38)
LCD_CS: J4.6, U20.7 (IO7)
LCD_DC: J4.7, U20.6 (IO6)
LCD_MISO: J4.3, U20.38 (IO2)
LCD_MOSI: J4.4, U20.19 (IO11)
LCD_RST: J4.8, U20.5 (IO5)
LCD_SCK: J4.5, U20.20 (IO12)
LDO_EN: U20.21 (IO13); also elsewhere on the board
LED_STAT: R58.1, U20.25 (IO48)
LED_STAT_A: D4.2 (A), R58.2
TP_INT: J4.12, U20.8 (IO15)
TP_RST: J4.13, U20.9 (IO16)
U0RX: J2.2, U20.36 (RXD0)
U0TX: J2.1, U20.37 (TXD0)
USB_DN: J3.A7 (D-), J3.B7 (D-), U20.13 (IO19), U21.3 (I/O2), U21.4 (I/O2)
USB_DP: J3.A6 (D+), J3.B6 (D+), U20.14 (IO20), U21.1 (I/O1), U21.6 (I/O1)
USER_BTN: R57.2, SW3.1, U20.23 (IO21)
VBUS: J3.A4 (VBUS), J3.A9 (VBUS), J3.B4 (VBUS), J3.B9 (VBUS), U21.5 (VBUS); also elsewhere on the board
VIN_SENSE: U20.4 (IO4); also elsewhere on the board
VR_ALERT: U20.24 (IO47); also elsewhere on the board
VR_EN: U20.18 (IO10); also elsewhere on the board
VR_RDY: U20.22 (IO14); also elsewhere on the board

Notes on the sheet:
esp
usb
disp
fan
mech
cooler

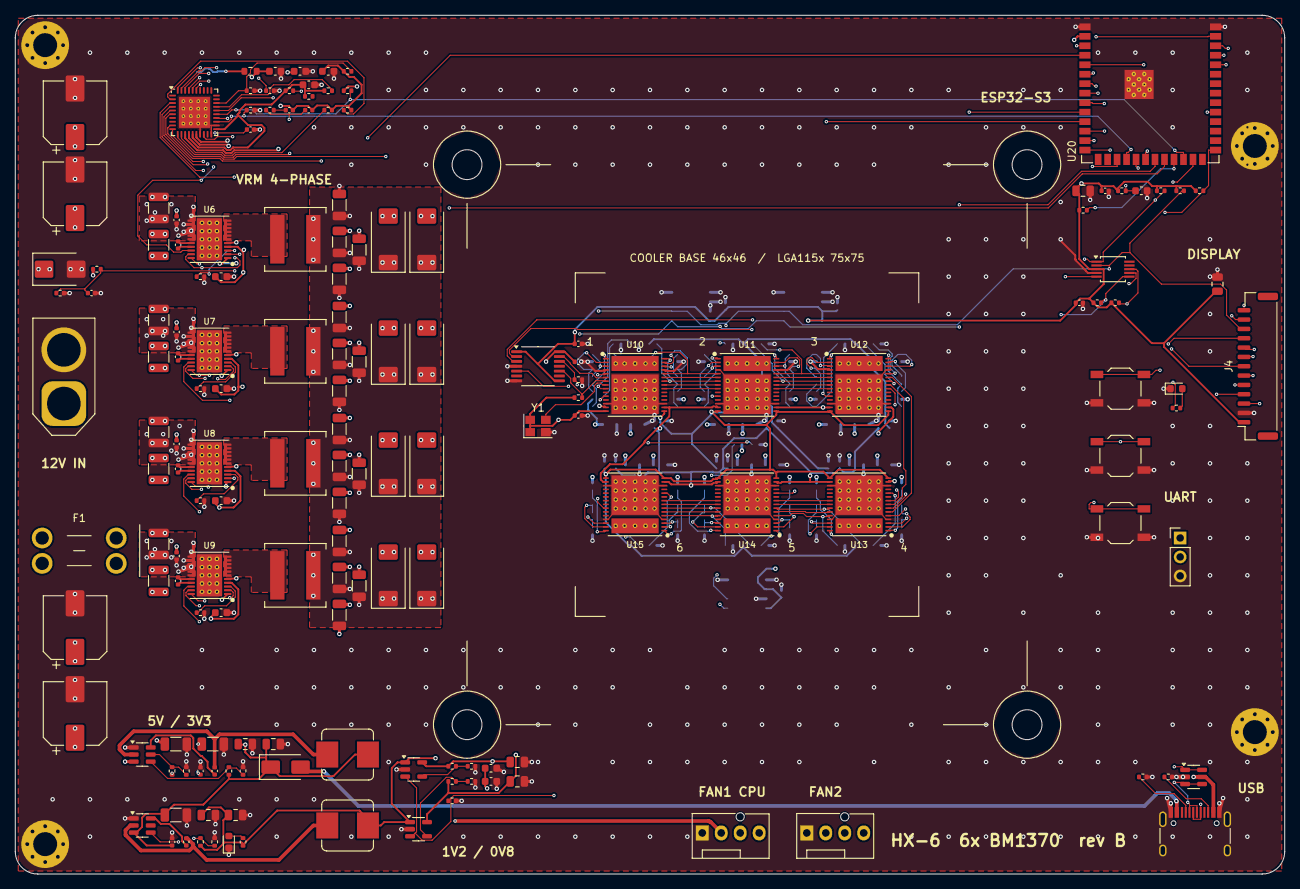
[picture p11: board hx6.kicad_pcb from above]

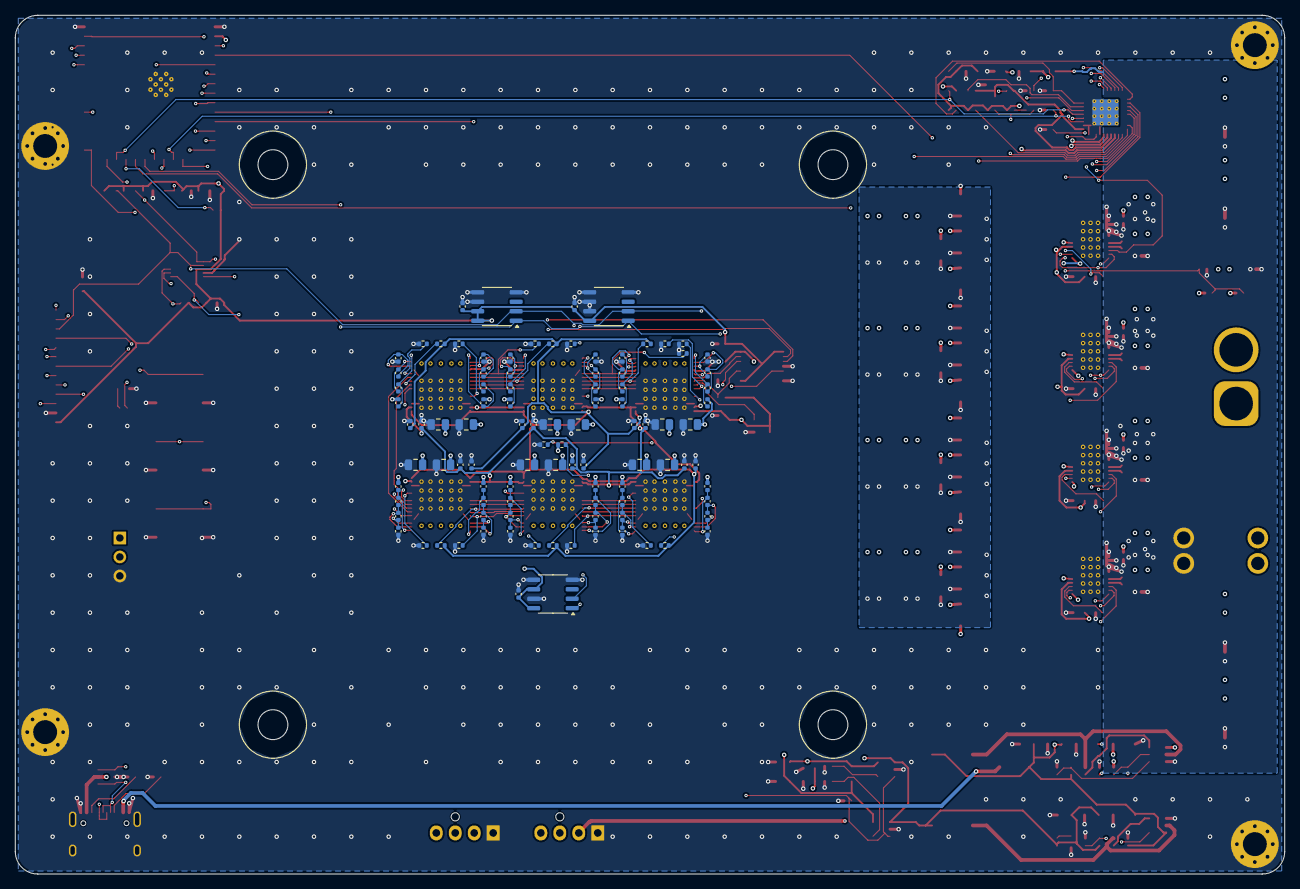
[picture p12: board hx6.kicad_pcb from below]

Board: 6 copper layers, 170.0 x 115.0 mm, 267 parts (98 on the bottom side), 163 nets.
